andresjjn/soma-arms/docs/media/camera/2026-10-26/lane_marks_measured.jpg

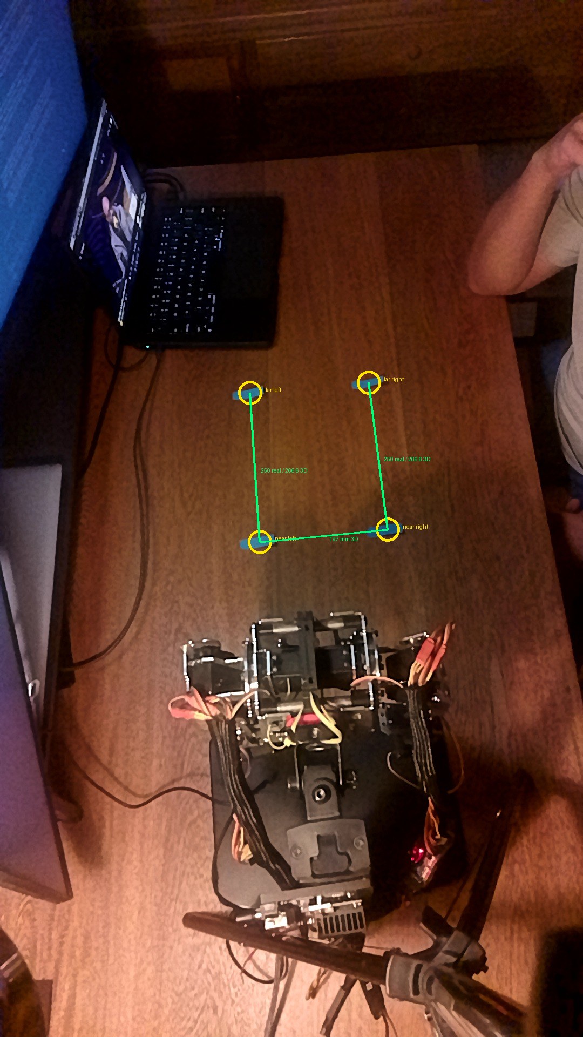
docs/media/camera/2026-10-26/lane_marks_measured.jpg
