andresjjn/soma-arms/calibration/camera_reference.jpg

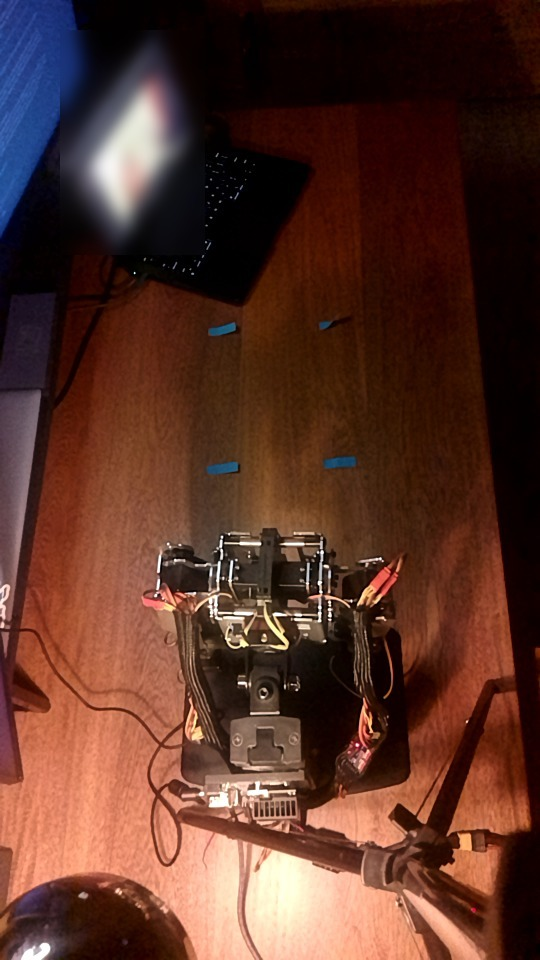
calibration/camera_reference.jpg
