andresjjn/soma-arms/README.md

# SOMA

**S**killed **O**perator via **M**imicry and **A**utonomy.

An embodied AI library for two 6DOF aluminum arms with a powered torso lift.
Real hardware: MG996R servos and an Actuonix L16 linear actuator on two
PCA9685 boards, driven from a Jetson Orin Nano Super running ROS 2 Humble in
Docker.



SOMA is standalone. It describes and drives the arms and the torso, and
nothing else: no chassis, no wheels, no navigation. Putting it on a mobile
base is the integrator's job, done by calling the `soma_torso` xacro macro
with their own parent link.

---

## The robot

| | |
|---|---|
| Arms | 2 x 6DOF aluminum, ThanksBuyer / Red Sun Global frame, "Arm Only" variant |
| Joints per arm | base yaw, shoulder, elbow, wrist pitch, wrist roll, geared gripper |
| Arm servos | 12 x Tower Pro MG996R, 25T spline, 500 to 2500 us over 180 degrees |
| Torso lift | Actuonix L16-140-63-6-R, 140 mm stroke, 20 mm/s, self locking. Off the hanging bench until the printed torso |
| Driver boards | 2 x PCA9685, 16 channels each, one I2C bus: `0x40` right arm and L16, `0x43` left arm, 50 Hz |
| Servo power | ATX bench supply behind a 10 A fuse, one 6 V UBEC per arm |
| Compute | Jetson Orin Nano Super 8 GB, JetPack 7.2, ROS 2 Humble in Docker, on its own wall adapter |
| Camera | Luxonis OAK-D Lite, RGB and stereo depth, verified on the Jetson; from v0.3 fixed on the column looking down at the deck |

Thirteen actuators on one I2C bus. Full part numbers, datasheets, the kit
parts list and every measured value: **[docs/hardware.md](docs/hardware.md)**
and **[docs/wiring.md](docs/wiring.md)**. The first power-up, in July 2026,
ran on a Raspberry Pi 5 and a 2S LiPo; hardware.md keeps that as history.

Honest numbers, because they shape everything else: the frame is advertised
for 25 kg.cm servos and the MG996R delivers about 10, so **useful payload is
around 330 g at 30 cm of reach**. SOMA is built to work in compact poses.

---

## Safety first

SOMA can hurt itself and you. Four things are worth knowing before anything
else, and the full model is in **[docs/safety.md](docs/safety.md)**:

1. **The driver boots on a mock backend and disarmed.** Going live needs both
   a launch parameter and an explicit service call. Two independent gates, on
   purpose.
2. **The lift is limited to 5 to 135 mm of its 140 mm stroke.** Holding a
   command against a stop wedged the lead screw once and it had to be freed by
   hand. It will not happen twice.
3. **Energise the 6 V rails only with both arms at rest in a compact pose**:
   on the hanging bench, hanging with nothing under or around them. These
   servos twitch at power-up.
4. **The real emergency stop is the switch that feeds the servo rails**,
   today the ATX rear switch. Keep it in reach.

---

## Quick start

Nothing below touches hardware.

```bash
# in a ROS 2 Humble workspace
git clone https://github.com/andresjjn/soma-arms.git src/soma-arms
colcon build --symlink-install && source install/setup.bash
```

See the model in RViz with a slider per joint:

```bash
ros2 launch soma_description display.launch.py
```

One arm on its own, which is the model to use with calipers in hand:

```bash
ros2 launch soma_description display.launch.py model:=single_arm.urdf.xacro
```

Run the driver in mock mode and watch the torso rise:

```bash
ros2 launch soma_driver driver.launch.py
ros2 topic pub --once /soma/command sensor_msgs/msg/JointState "{name: [torso_lift_joint], position: [0.135]}"
```

Run the tests, no ROS and no hardware needed:

```bash
python -m pytest soma_driver/test -q
```

---

## Interface

| Kind | Name | Type |
|---|---|---|
| Subscriber | `/soma/command` | `sensor_msgs/JointState`, target positions |
| Publisher | `/joint_states` | `sensor_msgs/JointState`, ramped current pose |
| Service | `/soma/arm` | `std_srvs/SetBool`, arm or disarm the real output |

---

## Roadmap

Every version is a git tag, a video in this README, and a short. The project
has an end: at v1.0 it closes and the arms move on to their next life as the
manipulator of a mobile platform. Anything still missing at v1.0 becomes an
issue, not a reason to keep the project open.

| Version | Milestone | What has to be true | Status |
|---|---|---|---|
| **v0.1** | Calibrated URDF | Every `[calibrate]` length measured with calipers and corrected, servo zeros and ranges captured, model right in RViz, CI green | **TAGGED 2026-08-10.** Caliper session 2026-08-05: real hanging-bench configuration modeled (parallel J1-J4 axes, 33 mm clavicle); FK predicted the fingertips 5.7 mm above the plate and the photos agreed. Axis signs pinned down at the first powered session |
| **v0.2** | Real driver | All 12 joints sign-checked through the ROS driver on both arms; a primitive sequence played end to end under the ramp, filmed (written as `wave`; closed with `hello_left`, see status) | **TAGGED 2026-10-27.** Sign check of all 12 joints on 2026-10-12, the re-seated right elbow and wrist pitch again on 2026-10-26. The wave ran clean on the metal on 2026-10-26 but was not filmed; the film is `hello_left`, which asks more of the driver: real radians from the joint probe, six joints at once, the base at about 142 deg, flowing through its poses, the idle arm limp. [Video](docs/media/video/v0.2_hello_left_2026-10-26.mp4) |
| **v0.3** | Cell geometry and eye-deck calibration | A laser-cut deck with one lane and three pockets per arm, the OAK-D fixed on the column, a pixel-to-deck homography, planar analytic IK. Acceptance: **click a pocket in the image and the gripper touches its center within 5 mm**, 10 of 10, repeated after a power cycle | Reach map and deck drawing done (`scripts/workspace_map.py`, `docs/workspace_map.svg`) |
| **v0.4** | Scripted tending cycle | Pick and place between pockets with no cloud: 30 consecutive cycles per arm without a drop, then a one hour soak with servo temperatures logged | |
| **v0.5** | The supervisor | `soma_agent`: Gemini Robotics ER 2 points, verifies success, reads the part id and recovers a dropped part, through function calls restricted to the primitives (the reasoner proposes, the armed driver disposes; the cloud can never arm the robot). Acceptance: 50 verified cycles with one induced fault recovered | Probe written (`scripts/er2_probe.py`); API billing pending |
| **v1.0** | The operator | Six to seven hours of continuous tending cycles, both arms, a public cycle counter **verified by the supervisor**, the video unedited. Then the project closes | |

Packages arrive with their milestone: `soma_agent` (the ER 2 supervisor) at
v0.5, `soma_operator` at v1.0. There is no MoveIt package and no learning
track on the ladder: the chain is planar, so a short analytic IK replaces a
planner, and the RL work was removed on 2026-10-03 to keep every evening on
the demo. Vision teleop by human mimicry stays in the post-1.0 backlog.

Why a tending cell and not something flashier: each arm is a planar chain
in its own vertical plane, 162 mm from the other one, with no lateral
joint at all. Each arm works a lane, the two arms can never hand anything
to each other, and the honest job for that geometry is machine tending:
pick a part from INPUT, load it into a fixture, unload it to OUTPUT, swap
the roles when INPUT is empty, repeat for hours. The engineering behind
every number is in **[docs/plan.md](docs/plan.md)**.

Videos land here as each tag ships.

- **v0.2**, 2026-10-26: [`hello_left`](docs/media/video/v0.2_hello_left_2026-10-26.mp4), the left arm rises folding the elbow, greets at the top and comes home, flowing, under the ramp (11 s, 720 px).

---

## Layout

```
soma_description/   URDF/xacro, SRDF, RViz config
soma_driver/        PCA9685 driver (mock and real) plus the safety test suite
docs/               see below
scripts/            smoke_test.sh, check_model_driver_sync.py, check_test_results.py
docker/             headless ROS 2 Humble image for building and validating
```

| Document | What it covers |
|---|---|
| **[docs/plan.md](docs/plan.md)** | **the master plan: hardware roles, what the planar arms can reach, the tending cell, the version ladder and the acceptance gate of every version** |
| [docs/log.md](docs/log.md) | the bench and decision log, one entry per session, measured facts first |
| [docs/hardware.md](docs/hardware.md) | every part, its datasheet numbers, and the measured values that override them |
| [docs/wiring.md](docs/wiring.md) | the verified channel map, power chain, connectors, bring-up order |
| [docs/safety.md](docs/safety.md) | the rules, how each is enforced in code, and the incident log |
| [docs/bench.md](docs/bench.md) | validated commands, RViz in a browser, the calibration procedures |
| [docs/session_v02.md](docs/session_v02.md) | the printable runbook of the v0.2 bench session: power-up, the two gates, the sign check, the wave |
| [docs/migration.md](docs/migration.md) | what carried over from the bench driver and what was deliberately changed |

## Development

CI runs on every push: the pure Python test suite, a full ROS 2 Humble build,
`check_urdf` on all three models, a consistency check between the URDF and the
driver, and an end to end run where the mock driver bends the left elbow
and TF confirms the fingertip rising 295 mm.

```bash
bash scripts/smoke_test.sh   # the same thing, locally, inside a ROS environment
```

## License

MIT. See [LICENSE](LICENSE).
