andresjjn/soma-arms/docs/media/camera/2026-10-26/reference_depth.jpg

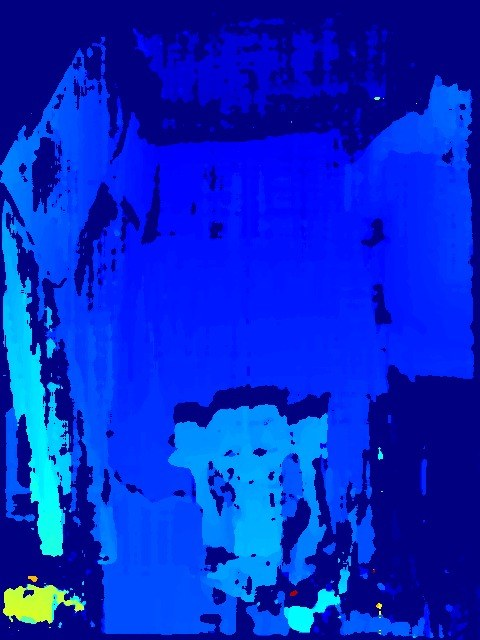
docs/media/camera/2026-10-26/reference_depth.jpg
