andresjjn/soma-arms/docs/calibration_report.md

# Calibration worksheet (v0.1)

Generated by `scripts/calibration_report.py` from
`soma_description/config/dimensions.yaml`. Do not edit by hand;
write the measurements into the yaml (value, status: measured,
date) and into the xacro, then regenerate. CI keeps both in sync.

Angles and axis-to-axis lengths are center of screw to center of
screw. Measure in mm with the caliper; the yaml stores meters.

## arm  (`soma_description/urdf/soma_arm.xacro`)

| dimension | estimate (mm) | status | put the caliper on | measured (mm) |
|---|---|---|---|---|
| `base_lx` | 95.0 | estimated | base box |  |
| `base_ly` | 95.0 | estimated | base box |  |
| `base_lz` | 62.0 | estimated | base box |  |
| `turntable_r` | 42.0 | estimated | turntable disc diameter / 2 |  |
| `turntable_h` | 12.0 | estimated | turntable disc thickness |  |
| `shoulder_off_z` | 45.0 | estimated | disc top face to shoulder servo AXIS (screw center) |  |
| `upper_len` | 120.0 | estimated | shoulder axis to elbow axis |  |
| `fore_len` | 90.0 | estimated | elbow axis to wrist pitch axis |  |
| `wrist_len` | 55.0 | estimated | wrist pitch axis to roll flange face |  |
| `gripper_base_h` | 45.0 | estimated | roll flange face to finger gear axis |  |
| `finger_len` | 75.0 | estimated | finger gear axis to fingertip |  |
| `finger_sep` | 24.0 | estimated | distance between the two finger gear axes |  |
| `plate_w` | 30.0 | estimated | link plate width |  |
| `plate_t` | 60.0 | estimated | outer depth of the plate pair |  |
| `effort_nm` | 1000.0 | estimated | stall torque in N.m (F4 calibration with power) |  |
| `vel_rads` | 3000.0 | estimated | no-load speed in rad/s (F4 calibration with power) |  |

## torso  (`soma_description/urdf/soma_torso.xacro`)

| dimension | estimate (mm) | status | put the caliper on | measured (mm) |
|---|---|---|---|---|
| `bay_lx` | 170.0 | design | electronics bay length (fits the rover deck 194x110) |  |
| `bay_ly` | 110.0 | design | electronics bay width |  |
| `bay_lz` | 70.0 | design | electronics bay height |  |
| `col_h` | 200.0 | design | column height including the 8 mm rails |  |
| `plate_lx` | 180.0 | design | shoulder plate length |  |
| `plate_ly` | 150.0 | design | shoulder plate width |  |
| `plate_lz` | 8.0 | design | shoulder plate thickness |  |
| `arm_x` | 35.0 | design | arm mount offset X on the plate |  |
| `arm_y` | 58.0 | design | arm mount offset Y on the plate |  |

25 of 30 dimensions still need a measurement. v0.1 closes when this number is zero for the `arm` section (`design` entries close with the torso build).
