andresjjn/soma-arms/(commit log)

2026-07-25 Bootstrap SOMA: description and driver packages, safety model, CI
    Standalone embodied AI library for two 6DOF aluminum arms with an
    Actuonix L16 torso lift, driven from a Raspberry Pi 5 over a PCA9685.
    soma_description
    - soma_arm.xacro: the 6DOF arm as a reusable macro, joints named after
    the A to F labels in the kit manual
    - soma_torso.xacro: electronics bay, L16 prismatic lift, torso plate,
    two arms at +/- 45 degrees and the OAK-D head, parameterised by parent
    link so any platform can mount it
    - bench models (single arm, full bench, sim with ros2_control), SRDF,
    MoveIt kinematics and RViz config
    soma_driver
    - servo_map.py: channel map verified with power on, inverted L16
    conven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
    [controllers.yaml, materials.xacro, single_arm.urdf.xacro, soma_arm.xacro, soma_bench.urdf.xacro, soma_bench_sim.urdf.xacro, soma_control.xacro, soma_torso.xacro]
2026-07-25 Fix the smoke test step: container paths and a tolerant TF read
    github.workspace expands to the host path, which does not exist inside
    the job container, so the script was never found. Derive the workspace
    from the working directory instead.
    Also make read_z return empty rather than tripping set -e, and print
    topics plus a /joint_states sample when the transform is missing.
2026-07-26 Align docs and rules with the hardware handoff, fix the I2C root cause
    Corrections against the bench log:
    - The I2C drops were NOT servo inrush current bouncing the ground rail.
    They correlated with handling and vibration, and the cause was a dupont
    jumper broken inside its insulation. The fix was four new short cables;
    the last drop never recovered, even after 20 retries. retry_i2c is now
    documented as a net under isolated glitches, not as the fix.
    - One UBEC is fitted, not two. The second, one per arm, is planned.
    - Added the real supply chain: LiPo 2S, switch and fuse, UBEC 6 V, V+.
    Never the LiPo directly: 8.4 V full against a 7.2 V servo rating.
    Two inviolable rules from the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
    [test_servo_map.py]
2026-07-26 scripts/pi: no-power check and minimum-motion discovery (measured map, L16 on ch3)
    Copied from the canonical Waver repo (ROS2_Docker_twin/scripts/pi/),
    translated to English. Logic identical: 50 Hz + register echo + FULL_OFF
    in the check; 60 ms bursts, one channel at a time, in the discovery.
2026-07-26 dimensions.yaml with provenance, sync test, and the caliper worksheet
    - soma_description/config/dimensions.yaml: single source of truth for
    every physical dimension, with value/status/source/date per entry
    (estimated, measured or design).
    - test_dimensions_sync.py: fails if a xacro literal and the yaml ever
    disagree, if a new literal lands without provenance, or if the torso
    soft limits drift from SERVO_MAP (wedging protection stays pinned).
    - scripts/calibration_report.py generates docs/calibration_report.md:
    the fill-in worksheet for the caliper session. 25 of 30 pending.
    [calibration_report.py, test_dimensions_sync.py]
2026-07-31 servo workbench: browser sliders to jog, zero and range-map each arm servo
    Single file tool for the F4-style calibration session (runs on Pi or
    Jetson). Safety encoded: starts disarmed and FULL_OFF, one active servo
    at a time, 500-2500us clamp, 50us max step per write, ALL OFF button,
    and the L16 torso deliberately excluded (wedging risk, see docs/bench.md).
    Captures zero/min/max per channel into servo_calibration.json.
2026-07-31 workbench: server-side 50 Hz ramp and a drag-safe UI
    The browser now only sets targets; a ramp thread walks the wire at
    400 us/s (same philosophy as rate_limit in the driver), so slider
    gestures cannot snap or stutter a servo. The UI builds its DOM once,
    never overwrites a slider being dragged, and throttles sends to one
    per 120 ms. First pulse on a channel still snaps from the unknown
    physical pose, documented as the one unavoidable jump.
    [servo_workbench.py]
2026-07-31 workbench: include the L16 torso with its own physics
    Channel 3 joins the sliders, but never as a plain servo: band clamped
    to its real 1000-2000 us interface, ramp matched to the actuator's
    20 mm/s so the signal cannot outrun the rod, and auto release 2 s
    after settling. The 2026-07-22 wedge needed a command held for ~8 s
    against a stop; that condition is now unreachable from this tool.
    Per-channel slider ranges come from the server state.
2026-07-31 README: bench milestone, 13 actuators verified live through the workbench
2026-07-31 Roadmap pivot: eye-hand at v0.3, Gemini Robotics-ER 2 orchestration at v0.4
    The ER 2 model (public API since 2026-07-30) becomes the task planner and
    cycle verifier of the operator milestone. New acceptance for v0.3: click a
    point in the image and the arm touches it. Bimanual language-directed pick
    and place at v0.4. Mimicry teleop moves to post-1.0 backlog. New inviolable
    rule: the cloud reasoner proposes, the armed driver disposes; no API
    response may arm, widen limits or bypass the ramp.
2026-07-31 docs/plan.md: the master plan, demo track plus learning track
    Covers hardware roles and the compute topology, what makes a URDF RL ready
    (seven requirements, each tied to an artifact), the model pipeline from
    dimensions.yaml to MJCF, the simulation stack decision (MuJoCo and MJX on
    Apple Silicon; Isaac Lab ruled out because it needs x86 plus RTX), the
    saturated position servo actuator model with the latency and backlash that
    decide sim to real on hobby servos, the RL task ladder L1 to L5, phase by
    phase acceptance criteria for v0.1 to v1.0, sequencing, invariants and
    named risks.
2026-08-02 plan: capture is a task type now, plus one-way door markers
    Section 11 defines when to capture (two stills before the rail comes up,
    one clip at session close), where it goes, and a three minute ceiling.
    Steps that destroy an unrepeatable state are marked FILM BEFORE in
    sections 6 and 10, because a one-way door does not feel different at 11pm.
    Also corrects a stale number: the suite is 50 passing plus 1 skipped, not
    the 24 that migrated from the bench driver. Our own metrics get the
    honest-numbers rule before anyone else's datasheet does.
2026-08-03 driver: minimum-jerk motion profiles, with the ramp demoted to a hard ceiling
    The linear ramp moved every joint at constant velocity with hard corners:
    infinite jerk at start and stop, a load spike into the gearbox both times,
    and motion that looks robotic. trajectory.py replaces it with the classic
    minimum-jerk quintic: velocity follows a bell, duration is chosen so the
    bell PEAKS at the per joint rate limit, and that limit is still enforced
    on every tick as a hard ceiling no polynomial can break. Retargeting
    mid-motion replans from the current position and velocity, so a new
    command never causes a discontinuity, and arming retargets in-flight
    trajectories to the current pose so they decele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
    [arm_controller_node.py, test_trajectory.py, trajectory.py]
2026-08-03 apply_calibration: workbench captures in, reviewed SERVO_MAP proposal out
    Converts servo_calibration.json into asymmetric joint limits around each
    measured zero, ready-to-paste ServoSpec rows and per joint URDF limit
    values. Emits a markdown proposal instead of editing code, because signs
    cannot come from pulse captures alone: every sign ships flagged UNVERIFIED
    until confirmed on hardware. Fingers anchor closed at the captured zero;
    the L16 turns measured stops into a 5 mm soft band, same rule as today
    but measured instead of assumed. Eight tests.
2026-08-04 The measured map: re-splined zeros, asymmetric limits, the hug convention
    On 2026-08-03 every horn was re-splined with its servo holding the
    electrical center, and the mechanical zero plus both travel limits were
    captured per channel with the workbench. This commit makes that capture
    the law of the repo:
    - SERVO_MAP now carries the measured rows. Sign convention (the hug
    rule): negative = inward, as if closing a hug, grasping features
    forward; positive = outward/up. Four arm channels are inverted
    (min_us > max_us) because that is how the mirrored geometry measures:
    rolls and yaws invert on opposite arms, elbows on both.
    - The xacro grows per-joint limit parameters (defaults = right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
    [servo_calibration_2026-08-03.json, soma_arm.xacro, soma_torso.xacro]
2026-08-04 real backend on smbus2, register level, with bus autodetection
    The Adafruit/Blinka stack is a platform detection layer that may or may
    not know JetPack 7.2; smbus2 is a plain kernel ioctl wrapper that the
    bench tools already validated on this exact chip, on the Pi (bus 1) and
    on the Jetson Orin Nano (bus 7). The real backend now speaks the same
    register protocol: 50 Hz via prescale 121, block writes per channel,
    FULL_OFF for release and ALL OFF. The lazy import moves fully behind the
    arming check, so the golden rule fires before any hardware library loads.
    New i2c_bus parameter (-1 = probe /dev/i2c-* for the chip).
2026-08-04 Jetson runtime: the driver in a Humble container with the I2C bus passed through
    JetPack 7.2 carries no ROS 2 Humble, so soma_driver runs in the existing
    validation image with /dev/i2c-7 passed through, host network and IPC for
    DDS, and smbus2 in the image. Boots MOCK and DISARMED like everywhere
    else; the two-gate ritual is documented in the compose header.
2026-08-05 Measured geometry 2026-08-05: hanging bench, planar arms, calibrated URDF
    The caliper session replaced every estimated arm dimension and revealed
    the real bench configuration, which the model now follows:
    - dimensions.yaml: every arm-chain length measured on the right arm,
    new bench section (central box, plate, column anchors), provenance
    per entry. Manual-photo estimates were off by up to 40 mm (upper arm
    79.3 mm real vs 120 estimated).
    - soma_arm.xacro: the arm as built, not as the manual drew it. Both
    arms HANG from their slew discs; J1 to J4 axes are PARALLEL (each arm
    a planar 4R chain plus wrist roll), with a 33 mm clavicle link from
    disc center to shoulder axis. New `side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
    [controllers.yaml, single_arm.urdf.xacro, soma_arm.xacro, soma_bench.urdf.xacro, soma_control.xacro, soma_torso.xacro]
2026-08-11 v0.2 groundwork: motion primitives, primitive CLI, and the sign-check bench tool
    - primitives.py: named poses and sequences as pure, tested data. home is
    the driver's boot pose by construction; compact IS home on the hanging
    bench (documented and pinned by a test); the torso lift is excluded
    from every pose because the L16 is not on this bench. settle_time_s
    exposes the minimum-jerk travel bound so dwells are provably long
    enough.
    - primitives_cli.py (ros2 run soma_driver soma_primitives): publishes
    poses and sequences to /soma/command; `relax` homes, settles, then
    disarms via /soma/arm. Holds zero safety logic of its own: the two
    gates stay in the driver.
    - sign_check_cli.py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
2026-08-11 L1 groundwork: a one-joint pendulum oracle proves the sim pipeline
    Before trusting MuJoCo with the 14-joint bench, trust it with a model
    pencil-and-paper physics can predict. Pattern borrowed from
    kimi-k3-in-c's 13-layer oracle: validate the engine on a miniature with
    the same structure as the real thing.
    - sim/pendulum_oracle.xml: one hinged box carrying the measured forearm
    numbers (75 x 31.9 x 52.8 mm, 160 g estimate), swinging undamped.
    - test_sim_oracle.py: the simulated small-angle period must match the
    analytic pendulum within 1 percent (tonight: 458.82 ms simulated vs
    458.60 ms analytic, 0.048 percent over 7 cycles) and energy must hold
    to 0.5 percent over 4 seconds of RK4.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
2026-08-11 Fix CI: module-level importorskip aborted collection on old pytest
    The ROS container runs pytest 6.2.5 with pluggy 0.13, where a Skipped
    raised while importing one module during collection kills collection of
    every sibling file: the smoke suite collapsed from 125 tests to 0 with
    exit code 5. Diagnosed by instrumenting the smoke step on a throwaway
    branch; the header "collected 0 items / 1 skipped" told the story.
    The oracle module now try-imports mujoco and skips via pytestmark at
    run time, which modern and ancient pytest both handle per-module.
    Verified in both worlds: without mujoco 118 passed 6 skipped, with
    mujoco 123 passed 1 skipped, exit 0 in both.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
    [test_sim_oracle.py]
2026-08-11 INA3221 driver: the power system gets eyes, register level with tests
    Read-only triple-channel monitor over smbus2, same lazy-import pattern
    as the PCA9685 backend. Carries the verified hardware facts of
    2026-08-10: default address 0x44 (0x40/41 belong to the PCA9685 plan),
    stock 0.1 ohm shunts with their honest +/-1.638 A ceiling, and the
    DCB203 battery floor (5S at 3.0 V/cell = 15.0 V) as a queryable
    battery_ok(). Unlike the PCA9685 it carries no arming gates, on
    purpose: no register on this chip can move metal, reading is always
    safe. Mock mirrors the interface for the driver integration that
    follows. Suite: 135 passed plus 1 skipped.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
    [ina3221.py, test_ina3221.py]
2026-08-11 Battery floor raised to 15.2 V to mirror the dock converter's UVLO
    The B0FP1B1F86 12 V dock cuts the pack at 15.2 V by hardware; software
    adopts the strictest guard in the system so the raw-adapter branch
    (which has no UVLO of its own) behaves exactly like the protected one.
    Chemistry floor (5S at 3.0 V/cell = 15.0 V) stays documented beneath it.
2026-08-12 INA3221 default address 0x41: bench-verified map replaces impossible 0x44 plan
    The A0 pin offers only 0x40-0x43 (datasheet SBOS576); the 0x44/45
    options recorded in the hardware inventory belonged to the rover's
    INA219, a different chip. Verified live on Jetson i2c-7 during the
    2026-08-11 soldering session: INA3221 at 0x41 answers manufacturer
    0x5449 ('TI') and die ID 0x3220, PCA9685 #2 at 0x43 (A0+A1 bridged)
    answers a virgin prescale, PCA9685 #1 keeps 0x40 with all 12 servos.
    The address test is edited because the physical fact changed, not to
    make anything pass: the no-collision principle it guards is intact.
    [ina3221.py, test_ina3221.py]
2026-08-12 Multi-board driver: per-channel I2C address routed through a backend fleet
    Every ServoSpec gains an address field defaulting to 0x40, so today
    nothing changes: a test pins that the whole map still lives on board 1
    and must be edited, saying so, on switchover day. The node now boots a
    fleet of mocks (one per board address in the map) and arms a fleet of
    real backends all-or-none: if any board fails to arm, the ones already
    up are disabled and the arming is refused. The golden rule holds board
    by board, before any hardware library loads.
    release() now takes the spec instead of a bare channel: with two boards
    on the bus (bench fact 2026-08-11, 0x40 in service and 0x43 standing
    by) a channel nu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
    [arm_controller_node.py, pca9685_backend.py, servo_map.py, test_multi_board.py, test_node_safety.py, test_servo_map.py]
2026-08-12 Battery veto in the node: INA3221 telemetry plus per-source arming floor
    battery_source parameter, default 'none' (exact pre-monitor behaviour).
    A named profile ('dewalt_5s' 15.2 V mirroring the dock UVLO so software
    fires before the hardware cut, 'lipo_2s' 6.4 V for the bench pack)
    publishes soma/power (sensor_msgs/BatteryState, 1 Hz, INA3221 channel 1)
    and refuses arming below the floor. The floor is a VETO, never a gate:
    nothing here can arm, the two existing gates stay the only way in.
    Fail safe by construction: if a profile is set and no INA3221 answers,
    the node runs and simulates but arming stays refused (the mock monitor
    reads 0 V). An unknown profile refuses to boot outright: broke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
    [arm_controller_node.py, ina3221.py, test_ina3221.py, test_node_safety.py]
2026-08-20 Left arm switchover: channels 9-4 move to board 0x43, numbers unchanged
    The six map rows gain address=0x43, exactly as the fleet design
    promised: six connectors plus one column, zero code. Pulses and limits
    are untouched on purpose, they belong to the servos and their horns,
    not to the driver board. The exact-table test gains the address column
    (a wrong board is now as much of a mis-drive as a wrong channel), the
    two-board pin replaces the nothing-changes pin as its own comment
    demanded, and the boot fleet test expects both boards.
    Board #2 has no silkscreen either: the first armed session re-confirms
    the left arm channel by channel, same ritual as 2026-07-22.
    Suite: 151 passing plus 1 rcl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
    [servo_map.py, test_multi_board.py, test_servo_map.py]
2026-09-01 CLAUDE.md: calibrate explanation level per domain (Andres is an electronics technician with control engineering studies; peer level on electronics/power/control, teaching mode on ROS and architecture)
2026-10-01 Channel map follows the 2026-10-01 harness: right arm 1-6 on 0x40, left 7-12 on 0x43
    Andres rewired both arms on the two-board harness: same order (gripper
    first, base yaw last), new ascending numbers, right being the robot's own
    right. Every pulse, limit and rate is untouched; they belong to the servos
    and their horns, not to the wiring. The dormant L16 moves from 3 to 15
    because the right wrist pitch now owns 3; channel 0 stays empty.
    Tests edited because the physical fact changed: the exact table gets the
    new numbers, test_measured_wiring_2026_07_22 becomes test_harness_2026_10_01,
    duplicate detection now keys on (board, channel), and the calibration
    converter tests use the new channels.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
2026-10-01 wiring.md: point at the renamed harness test
2026-10-01 wiring.md: the 2026-10-01 harness is not yet power-verified, say so
2026-10-01 Servo workbench: both boards, joint list read from SERVO_MAP, sliders start at the calibrated zero
    The workbench kept its own hand-copied channel table (the July layout,
    board 0x40 only), so after the 2026-10-01 rewire it would have mislabeled
    every joint and never reached the left arm on 0x43. It now derives
    board, channel, name and calibrated zero from SERVO_MAP, the single
    source of truth, drives every board on the bus, and finds the bus where
    all of them answer. ALL OFF reaches every board.
    Precision: sliders start at the map zero instead of the 1500 us servo
    center, so the one unavoidable first-pulse snap is as small as a hanging
    arm allows; a go ZERO button, +/-5 us nudges, and the an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
    [servo_workbench.py, test_workbench.py]
2026-10-02 Workbench: ALL OFF cuts each board on its own; start with the boards present
    Found on the bench: unplugging one arm's board made the workbench's
    request handlers raise on that board, and ALL OFF walked the boards in
    one loop, so a missing board could stop the cut from reaching the rest.
    A kill switch must not depend on every board being healthy: each board
    is now cut on its own and a failure is only reported. The workbench also
    refused to start with a board missing; it now runs with the boards that
    answer and leaves the missing board's joints off the page, with a warning.
    [servo_workbench.py]
2026-10-02 Workbench --raw: every channel of every board for a loose spare servo
    Bench need on 2026-10-01: proving each output of each board with one
    known-good spare servo, channel by channel. Raw mode lists all 16
    channels of every board that answers, starts each slider at the 1500 us
    neutral, and refuses calibration captures so a test can never pollute
    the calibration file.
    [servo_workbench.py]
2026-10-02 Channel map back to the proven descending layout (15-10 on 0x40, 9-4 on 0x43)
    The morning's 1-12 map came from a header counted from the wrong end:
    neither PCA9685 board carries a channel silkscreen. With it, the right
    arm went dead (pulses went to empty outputs 1-6) and the left arm's
    pulses landed on neighbouring joints, which is why a closed gripper
    command opened it. A pulse sweep plus a spare servo moved output by
    output (servo_workbench.py --raw) proved the physical truth: the
    August layout, gripper first, descending. L16 back on 3.
    Kept from the detour: duplicate detection keyed on (board, channel),
    the harness contract test (now test_harness_proven_2026_10_01), and
    apply_calibration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
    [check_model_driver_sync.py, servo_map.py, test_apply_calibration.py, test_servo_map.py]
2026-10-02 Workbench: watchdog disarms on a board reset; ARM re-configures the boards
    Seen on the bench 2026-10-01: reconnecting a board made both PCA9685s
    lose their shared 3.3 V logic supply for an instant. They came back at
    power-on defaults (MODE1 0x11, oscillator asleep; prescale 0x1E, 200 Hz)
    and every output went dead, while the page still showed ARMED and live
    pulses. A tool that reports ARMED over sleeping boards is lying.
    A watchdog now reads MODE1 and the prescale of every board once a
    second; a reset or a silent board disarms everything and puts the fault
    on the page. ARM re-runs the board init, so recovering is one click
    after fixing the supply.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
    [servo_workbench.py]
2026-10-02 Workbench: master slider for every joint at once, arms in two columns
    Bench request 2026-10-01 after capturing every servo's zero/min/max:
    see what happens when all joints get a signal together. One master
    slider: left walks each joint toward its own captured MIN, right toward
    its own MAX, center is zero, so 50 % is half of each joint's own travel.
    Direction follows the capture labels, which keeps inverted joints right.
    An amplitude cap (25 % by default) and per-arm checkboxes come with it:
    twelve servos at full travel at once will collide, both yaws can swing
    about 180 deg inward. Same 400 us/s ramp; a joint without a pulse yet
    snaps to its zero first, never straight to a far target.
    The p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
    [servo_workbench.py, test_workbench.py]
2026-10-02 Driver: disarm when a PCA9685 resets while ARMED
    Seen on the bench 2026-10-01: both boards (0x40 and 0x43 on i2c-7) lost
    their shared 3.3 V logic supply for an instant and came back at power-on
    defaults, MODE1 0x11 (oscillator asleep) and prescale 0x1E (200 Hz
    instead of 121 for 50.0 Hz). Every output went dead. The workbench got a
    watchdog for it; the ROS driver had the same blind spot: it would keep
    writing LED registers to a sleeping chip and keep reporting ARMED.
    Backend: every board now answers config_fault() / is_configured().
    RealPca9685 reads MODE1 and PRESCALE and flags the SLEEP bit or a
    prescale other than 121; the mock is always healthy unless a test calls
    simulate_reset(). The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
    [arm_controller_node.py, pca9685_backend.py, test_board_reset.py, test_node_safety.py]
2026-10-02 Calibration of 2026-10-01: every arm joint re-captured on the two-board bench
    Andres re-captured, with the servo workbench, the mechanical zero and
    both travel limits of all 12 arm servos. The raw file is committed next
    to the August one (calibration/servo_calibration_2026-10-01.json). The
    rows were generated from it, not typed: each MIN capture lies on the
    negative (hug) side and each MAX on the positive side, and every joint's
    direction was checked against the August measured inversion before
    writing (all 12 agree; the generator refuses on any mismatch).
    Why now: the August numbers had drifted by up to 205 us (18 deg on the
    right elbow), and several August limits sat BEYOND today's measur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
    [servo_calibration_2026-10-01.json, soma_arm.xacro, soma_bench.urdf.xacro]
2026-10-02 Workbench sequence player: primitives.py sequences, minimum jerk, step by step
    The workbench can now play any SEQUENCE from soma_driver/primitives.py,
    the same source the ROS driver's soma_primitives CLI uses, so a motion is
    defined once for both paths. plan_sequence converts each pose through
    SERVO_MAP (clamped) and gives every step the driver's worst-case
    minimum-jerk travel time at the 2.5 rad/s cap; the player interpolates
    all joints of a step on one synchronized minimum-jerk profile at 50 Hz
    (the 400 us/s slider ramp would be far too slow for a wave). Step-by-step
    mode waits for a click after each step, to check every direction on the
    metal before running a sequence at speed. Stop, ALL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
    [servo_workbench.py, test_primitives.py, test_workbench.py]
2026-10-03 Right-arm wave: raised with the base, three forearm waves, hand opening on each out-swing
    Five wave_* poses and SEQUENCES['wave'] for the v0.2 video. The arm goes
    up with yaw (the one direction verified on the metal, negative = forward)
    and never with the shoulder, whose forward travel may be 25 deg; the
    elbow curls the forearm about 25 deg off vertical and oscillates between
    -1.57 and -2.09 rad while the gripper opens and closes. Every arm value
    keeps at least 0.3 rad to a measured limit, every step moves at most
    1 rad (the finger, inclusive), every dwell leaves 0.25 s over the
    minimum-jerk travel. The left arm stays at home. The elbow direction is
    not verified yet, which the docstring says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
    [primitives.py, test_wave.py]
2026-10-03 soma_primitives --step: one pose per ENTER, q unwinds home along the proven path
    The sequence player moves into player.py, pure and tested without ROS;
    primitives_cli.py becomes a thin rclpy adapter. In step mode the human
    confirms every pose but the last. An abort does not jump to home (from
    the top of the wave that is a 2 rad elbow move through territory whose
    sign may be wrong): it retraces the states already published, newest
    first, each at most 1 rad per joint with settle plus margin, and ends
    at home. The player never calls /soma/arm; relax stays the only caller,
    and only with False.
    parse_cli drops the whole --ros-args segment (the old filter only
    removed the token itself). Exit code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
    [player.py, primitives_cli.py, test_player.py, test_primitives_cli.py]
2026-10-03 Workspace map: planar reach of each lane and the deck drawing for the laser cutter
    scripts/workspace_map.py does planar FK and analytic IK of the 4R chain
    (yaw, shoulder, elbow, wrist pitch plus the 150 mm tool) from the
    measured dimensions and the measured limits, and reports the x interval
    of each lane where a vertical gripper can reach a given height. Signs
    are hypotheses except the yaw: --flip mirrors one joint and its limits
    so the map is redone the evening the sign check lands.
    Findings of 2026-10-03 (URDF signs, 0.1 rad inside every limit): the
    lanes sit at y = +-62.3 mm, 124.6 mm apart; reach is short and not
    monotonic in deck height (a 140 mm band at plate level, about 240 mm at
    60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
    [test_workspace_map.py, workspace_map.py]
2026-10-03 ER 2 probe: one pointing call to gemini-robotics-er-2-preview, key from the environment only
    scripts/er2_probe.py sends one frame and a list of labels, prints the
    raw answer, the parsed [y, x] points (0 to 1000) and their pixels, the
    latency and the token usage: the numbers the v0.5 cost and latency log
    needs before anything is designed around the model. The model id is
    configuration (SOMA_ER2_MODEL or --model) because ER 1.5 and 1.6 were
    retired within months. The Google SDK is imported only inside query(),
    so the module and its parsers are tested where no SDK and no network
    exist, and a missing key stops main() before any call. No ROS, nothing
    that can reach the driver.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
    [er2_probe.py, test_er2_probe.py]
2026-10-03 Plan restructured: task-gated ladder to a two-station tending cell, learning track removed
    docs/plan.md rewritten around what the arms can physically do: each arm
    is a planar chain in its own vertical plane, 124.6 mm from the other,
    so each works a lane and the honest job is machine tending (INPUT,
    MACHINE with a lamp, OUTPUT; roles swap when INPUT empties; both arms
    interleaved; the supervisor verifies every cycle). Versions are gates,
    never dates: v0.2 driver (sign check plus the wave), v0.3 cell geometry
    and eye-deck calibration (laser-cut deck, camera on the column,
    homography, planar IK; click a pocket and touch its center within 5 mm),
    v0.4 scripted cycle with a one hour soak and tempe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
    [soma_arm.xacro, soma_torso.xacro]
2026-10-04 The bench and decision log moves into the repository: docs/log.md
    SOMA is an independent project and its log lived in the Waver repository
    by inertia of the July handoff. From 2026-10-03 the log is docs/log.md
    here, with the 2026-09-01, 2026-10-01 and 2026-10-03 sessions carried
    over in English (resumption and the inrush incident, the network and
    camera verification, the harness lesson, the shoulder limit cycle, the
    verified yaw direction, the plan restructure and the Gemini facts). The
    safety incident log gains the three incidents it was missing (inrush,
    harness counted from the wrong end, board reset after a 3.3 V glitch).
    CLAUDE.md and the README point at the log; the Waver files become a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
2026-10-04 Handoff for the next (local) session: v0.2 bench runbook and a corrected sign check
    The cloud session closes on 2026-10-04 and work continues on Andres's
    Mac, which can reach the Jetson. docs/next_session.md carries the audit
    of the bench tools (soma_sign_check walks both arms, drives the right yaw
    within 1.4 deg of its stop, leaves a joint displaced on Ctrl-C and
    prescribes an axis flip where a SERVO_MAP mirror is the right fix; no
    Jetson recipes; no way to relaunch with allow_real; a wrong claim that
    arming never moves anything; the XT60 is not an emergency stop) and the
    approved plan to fix them before the first armed session.
    Clau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
2026-10-09 Sign check rewritten: pure logic in sign_check.py, a thin rclpy adapter, tests
    The audit of 2026-10-04 found the old soma_sign_check unfit for the
    bench: it walked all 12 joints with no per-arm option, sent the right
    yaw to +0.25 rad (1.4 deg from its measured +0.2749 stop), left a joint
    at its target on Ctrl-C, and answered a mismatch with an axis flip in
    soma_arm.xacro, which is the wrong fix: metal moving opposite to the
    hug convention is a driver fix (mirror the SERVO_MAP row), and every
    planar <axis> line uses ${side}, so a flip there changes both arms.
    sign_check.py (no ROS, the player.py pattern):
    - joints per arm in confidence order (yaw first, it is verified on the
    metal and prov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
    [player.py, sign_check.py, sign_check_cli.py, test_player.py, test_sign_check.py, test_sign_check_cli.py]
2026-10-09 soma_primitives --step: discard keys typed during a step
    Same hazard the sign check closes with fresh_input(): an ENTER pressed
    while a pose is still moving waits in the terminal buffer and answers
    the next prompt the moment it appears, so a double ENTER walks two
    steps of the wave with nobody looking at the first. Step mode now
    flushes pending input before every prompt.
    The docstring also says what Ctrl-C does today: it ends the program
    and leaves the arm at the last pose, still held by the armed driver.
    q is the abort that unwinds along the proven path.
2026-10-09 Jetson operating docs: gate 1 by relaunch, what arming really sends, the ATX stop
    docker-compose.jetson.yml launches with allow_real:=${ALLOW_REAL:-false},
    so gate 1 finally has a recipe on the Jetson: ALLOW_REAL=true ... up -d
    --force-recreate, closed again by a plain relaunch. The header names
    two traps: restart: unless-stopped keeps a container's configuration
    across reboots (one created with ALLOW_REAL=true comes back with gate 1
    open), and compose reads .env on its own (ALLOW_REAL never goes there).
    `docker compose config` validates both forms.
    docs/bench.md, new section 6: ssh, i2cdetect on bus 7, compose up /
    logs / down, how new code reaches the driver, a `soma` helper that
    passes a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
    [soma_arm.xacro]
2026-10-09 docs/session_v02.md: the printable runbook of the v0.2 bench session
    Checkboxes and a pen, steps 0 to 9 as planned: prerequisites, aborts
    and the capture before the ATX; power-up; an optional mock rehearsal;
    gate 1 by relaunch; gate 2 by Andres, out loud; the right-arm sign
    check; the decision (any reversed ends motion for the day, the fixes
    are desk work); the wave in step mode, then filmed; the shoulder
    threshold with its pulse table; close, the log entry, and the left arm
    the same day if everything was clean.
    What it adds to the plan:
    - The expectation tables are generated by expectation_table() and a
    test keeps the printed copies identical to what the tool commands.
    - RViz is not part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
    [test_sign_check.py]
2026-10-09 Log of 2026-10-09; the handoff is done and goes
    docs/log.md gets the desk session that executed docs/next_session.md:
    what was built, the corrections found on the way (rclpy's SIGINT
    handler shuts the context down on Humble; arming sends the believed
    pose at the servo's own speed; no --flip after a driver fix; the model
    check needs no metal; gate 1 outlives a reboot; an ATX stop leaves the
    driver armed; typeahead; the soma helper's quoting), and a desk
    prediction for the model check, from a pure Python FK of the xacro:
    planar joints drawn negative = forward on both arms, the wrist rolls
    drawn CW (right) and CCW (left) seen from above for a negative command,
    and both grippers drawn closing, t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
2026-10-12 Workbench: the watchdog reads the bus under the lock
    Every access to the workbench's shared SMBus held the fleet lock except
    the 1 Hz watchdog's reads of MODE1 and PRESCALE. One SMBus serves both
    boards, and smbus2 sets the slave address and then transfers in two
    separate syscalls: a watchdog read landing between the two calls of a
    50 Hz ramp write would send that write to the other board. (The kernel
    serializes each transfer, so this never showed up as an OSError; the
    risk is a misaddressed write. With today's map such a write lands on an
    unused channel of the other board, by luck, not by design.)
    The pass is now check_boards(), entirely under the lock; _watchdog only
    loops over it. Two te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
2026-10-12 Jetson driver container: scripts/jetson_driver.sh, since there is no compose
    Found on 2026-10-12: the Jetson has no `docker compose`, so every
    compose recipe in bench.md, safety.md, wiring.md and the runbook could
    not run there. The container had been made by hand with `docker run`
    and allow_real:=true on 2026-10-02, and restart: unless-stopped kept
    gate 1 open across reboots for ten days. The docs also had the wrong
    repository path and a DHCP address that has since changed.
    scripts/jetson_driver.sh closed|open is docker-compose.jetson.yml as
    one `docker run`, same flags. It refuses while the driver's last
    arming event in its log is ARMED (removing an armed driver kills it
    before it cuts th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
2026-10-12 Log of 2026-10-12: the right arm's signs verified on the metal
    The first joints moved through the ROS driver: the right-arm sign check
    gave 6 of 6 ok, report in calibration/. Also logged: Andres's
    impression that the MG996R are weak and loose, what tells backlash,
    torque and V+ sag apart, and his decision to keep building and to
    evaluate servos with real position feedback when these become the
    limit; the OAK mounted looking at the operator instead of the plate,
    too close and upside down, with a yaw check that was confirmed but not
    run; the Jetson as found; and the plan changes from the review against
    the ER 2 docs, for a later edit of docs/plan.md.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
2026-10-12 Model fixed against the metal: wrist roll and finger axes, pinned by an FK test
    The sign check passed 12 of 12 on the metal on 2026-10-12, so the driver
    was right everywhere. The model was not: seen from above, a negative
    wrist roll turns the gripper inward on the metal (counterclockwise on
    the right arm, clockwise on the left, as Andres saw it), and the URDF
    drew both the other way. The URDF also drew a positive finger command
    as the two fingers closing and crossing, while the metal opens.
    soma_arm.xacro: the wrist roll axis goes from ${side} to ${-side} and
    both finger axes from 0 1 0 to 0 -1 0. Both arms disagreed the same
    way, so the shared lines are the right place. The driver, the joi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
2026-10-13 colcon test runs the driver suite, and CI fails when no test ran (squash)
    Squash of claude/compassionate-proskuriakova-b5edda (5 commits, CI green
    on its last two runs, 37977558879 and 37977774034). Its intermediate log
    entry made a claim that its last commit corrects; the squash keeps only
    the corrected version.
    - soma_driver/setup.py declares extras_require={'test': ['pytest']}.
    colcon picks pytest only from setup.py; without it, it fell back to
    unittest, found no test, wrote no XML and passed: "Summary: 0 tests"
    on main (runs 37964849489, 37965586501 and every run since).
    - scripts/check_test_results.py fails unless at least one test reached a
    verdict (tests minus skipped minus e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
2026-10-13 soma_primitives: Ctrl-C walks the arm home, over covered ground only
    From the work of the "Ctrl-C unwind like q" session (2026-10-09, left
    uncommitted in its worktree), reviewed and integrated on 2026-10-12.
    The bug it found, re-checked on main before merging: the unwind
    retraced the walked path literally, so `q` after the descending
    wave_probe, one move from home, climbed back through all three swings:
    12 moves. On the merged code it is 1 move (and 3 from the top of the
    climb, as before).
    - unwind() starts from the FIRST time the arm held its current pose and
    goes back one forward move at a time: only moves already made, each at
    most 1 rad, never the same pose twice. A move cut short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
2026-10-13 hardware.md and README describe the Jetson bench; July kept as history
    From the work of the "Update hardware.md and README for the Jetson
    bench" session (2026-10-09, left uncommitted in its worktree), reviewed
    and integrated on 2026-10-12.
    - README: two PCA9685 boards and the Jetson instead of one board and a
    Raspberry Pi, a "Servo power" row, the camera's real role. Safety
    point 3 no longer says "folded": on the hanging bench the first armed
    tick sends every joint to its hanging zero without a ramp, so arms
    folded by hand would jump. It says hanging at rest, as wiring.md does.
    - hardware.md: the bill of materials of today (ATX, two UBECs, the
    Jetson, the INA3221 off the bus), the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
2026-10-13 Inviolable rules 1 and 4 follow the Jetson bench; same-day reports keep the time
    Changed with Andres's explicit approval (2026-10-12):
    - Rule 1: "including over SSH on the Pi" becomes "on the Jetson", the
    computer that drives the boards since 2026-07-30.
    - Rule 4: "both arms folded, resting on the bench" becomes "both arms
    hanging at rest, nothing under or around them". On the hanging bench
    the hang is the compact pose, and folding the arms by hand before
    arming is the dangerous thing: the first armed tick sends every joint
    to its hanging zero with no ramp (TestWhatArmingSends).
    The right arm's sign check ran twice on 2026-10-12 (23:40, and 23:55 in
    the left arm's armed window, wh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
2026-10-13 Camera on the Jetson desktop, and ER 2 marks what it finds on the frame
    scripts/oak_view.py: a live view of the OAK-D Lite for aiming the camera
    and filming, RGB turned 180 deg (the camera is mounted upside down) and,
    with --depth, disparity beside it (extended disparity: the work area can
    sit near the stereo pair's minimum range). `s` saves the full-resolution
    frame to /tmp/soma_cam/frame.jpg for the probe; --snapshot saves one
    settled frame without a window. Tested on the Jetson with --snapshot
    --depth: 1920x1080 RGB right side up and 640x480 depth, USB SUPER. It only
    reads the camera.
    scripts/er2_probe.py: with no labels it asks with the pointing prompt of
    Google's robotics overview, ver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
2026-10-13 Handoff for the next session, and the evening of 2026-10-12 in the log
    docs/next_session.md: the state at the end of the day (main and the
    Jetson on fe67031, gate 1 open and the driver disarmed, the camera that
    must move, the depthai 3 examples and their local edits) and the pending
    list in order: the first ER 2 call, the gesture gripper (proposed, not
    decided), the arm mimic (post-1.0, not decided), the catalog fix for
    grippers_open before demo runs, the bench items toward the v0.2 tag, the
    plan edit, and the cleanup that waits for a yes.
    docs/log.md: the branches merged after review, the reworded rules, the
    camera viewer, what the depthai 3 examples taught (4 SHAVEs on the Lite,
    orientati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
2026-10-13 One gripper follows one hand: tracker on the OAK, bridge to the driver
    A bench experiment decided by Andres on 2026-10-12, one joint. The OAK-D
    Lite runs the MediaPipe palm detector and hand landmarker (8 fps on
    RVC2); how open the hand is sets how open one gripper is, in proportion.
    The tracker runs on the Jetson host (depthai 3 venv) and prints targets;
    a bridge inside the driver's container publishes them to /soma/command
    for that arm's driven finger only. It cannot arm, a lost hand sends
    nothing, and the driver clamps and ramps every target.
    The first runs on the bench shaped it: a wrist-position lock so the
    other hand cannot take over, a palm size that survives tilt, misreads
    skipped,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
2026-10-13 hand_gripper: the closed end holds, and the target moves smoother
    On the metal the left gripper followed Andres's hand well but fluttered
    near closed: 57 of 216 targets in 107 s sat between 0 and 0.2. The
    follower now takes the median of 3 readings (no one-frame spike reaches
    the gripper), averages with weight 0.3 instead of 0.5, and holds the
    ends with hysteresis: at or below 0.2 it shuts and stays shut until the
    hand passes 0.3; the open end mirrors it at 0.85 and 0.75. Replayed on
    the same run: 131 targets, none between 0 and 0.2.
    Two filter tests rewritten on purpose: they pinned the old filter (no
    median, no held ends), which Andres asked to change; no hardware fact
    moved. --smoothing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
2026-10-13 hand_gripper --present: open then close the hand, the arm lifts and shows
    For Andres's video. The bridge's new Presenter follows the hand with the
    gripper; after the hand stays open 0.5 s and then closes, it holds the
    gripper shut, curls the elbow to -1.65, lifts the base to -0.52 and rolls
    the wrist +-0.25 rad on a 3 s sine until the input ends, then walks home
    in reverse (wrist, base, elbow). Every target is streamed at 10 Hz on a
    minimum-jerk ramp, at most 2 rad/s, 0.3 rad or more from every measured
    stop.
    Why this pose: by the URDF's estimated masses a level forearm 50 deg
    forward asks the base for about 9.9 kg.cm, the MG996R's measured limit;
    this one asks about 7, the designed wave's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
2026-10-13 hand_gripper --present lifts the straight arm with the base only
    The first run on the metal curled the left elbow toward -1.65 with the
    arm hanging, and the forearm folded in and jammed against the central
    box from the start of the curl, where the model has 45 mm to spare: at
    large angles the elbow does not go where the model believes. Incident
    row in docs/safety.md.
    The show now swings the straight arm forward with the base alone
    (--lift, 0.52 rad = 30 deg by default, at most 0.7) and rolls the wrist
    +-0.25 rad; the elbow, shoulder and wrist pitch are never commanded, and
    a test pins that. By the model, 5.7 kg.cm on the base at 30 deg, 45 mm
    from the body.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
2026-10-13 hand_gripper: a lost hand walks home and releases; lift up to 45 deg
    Once a hand seen before has been gone for --release-after seconds
    (default 2), the tracker sends `release`. The bridge walks the arm home
    if it was raised, waits 1 s for the driver's ramp to land, and disarms:
    every servo goes limp, never while the arm is up (it would fall). The
    script can now disarm but still never arm: one SetBool request, built
    with data False. The test that forbade naming SetBool at all is
    rewritten on purpose to pin exactly that.
    --lift now goes up to 0.79 rad (45 deg): about 8.0 kg.cm on the base by
    the model, 80% of the MG996R's measured torque, so above 0.7 rad the
    show lasts at most 15 s.
    Co-Auth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
2026-10-13 hand_show.sh: one take of the hand show, armed only on a typed word
    A lost hand now disarms, so each take has to arm again; Andres asked for
    it in one command. hand_gripper.py still cannot arm. The new launcher,
    run on the Jetson in a terminal, checks that every arm joint of both
    arms reads 0.0 on /joint_states (hand_gripper.py --home-check, read
    only: the first armed tick sends the believed pose with no ramp),
    prints the rule 4 checklist, and calls /soma/arm only if "arm" is typed
    at its prompt; then it starts the tracker and the bridge with the given
    bridge options. An armed driver is not asked again. Gate 1 is not
    touched.
    Tested on a fake docker and a fake tracker; a mutated copy that a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
2026-10-13 hand_gripper: the show does its wrist rolls even if the hand leaves
    At 45 deg on the metal the wrist barely rolled: the hand left the frame
    right after the trigger and the release walked the arm home before the
    show had begun. The show is now a fixed number of full wrist cycles
    (--rolls, 4 of 3 s by default, within the existing time caps), then it
    comes home on its own. A release asked during the raise or the show is
    deferred until the show ends, then home, then the cut; before the
    trigger it is still immediate.
    The tracker keeps running after sending release, with a heartbeat line
    the bridge ignores: the write is how it learns the bridge has ended,
    and it keeps the pipe open so a Ctrl-C st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
2026-10-13 Camera on its mast: frames turned 90 deg, and a coverage check
    The OAK-D Lite is now fixed on a mast above the central box, tilted over
    the arms' forward arc and rolled a quarter turn. oak_view turns frames
    90 deg counterclockwise; the hand tracker does it with an ImageManip,
    since the depthai 3 camera node only offers 180 deg (both checked on
    real frames; addRotateDeg turns the opposite way, so -90 there).
    camera_check is a new catalog sequence: one straight arm at a time,
    swung forward by the base only to 15, 30 and 40 deg and back down the
    same way (40 deg is about 7.3 kg.cm by the model, the designed wave's
    load; the elbow stays out after the jam of 2026-10-12).
    scripts/camera_coverage.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
2026-10-20 camera_coverage: a color difference beside the depth one; handoff
    Metal inside the stereo blind zone has no depth, so the depth difference
    cannot see an arm right under the lens. Each capture now also reports
    the largest blob whose gray level moved against the baseline image,
    saved with the baseline. Checked on the Jetson: clean on an unchanged
    scene. The handoff is rewritten for where 2026-10-13 left off.
2026-10-26 soma_joint_probe: the real angle per radian, read with a phone level
    Every joint's radians are still the nominal 2000 us = 180 deg; the sign
    check proved directions, not magnitudes, and the left elbow jammed
    against the central box where the model saw room. The probe moves one
    planar joint at a time with the rest at 0.0, so the inclination of the
    link it drives, read from the vertical, is the joint's angle. It reads
    0.0 first, walks a staircase forward (0.2 rad by default, a ceiling per
    joint, 0.1 rad inside every captured stop), asks for a reading per
    stair, and walks back down the same stairs on q, x, Ctrl-C, end of input
    or any error. A least squares line gives the real scale, the zero er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
2026-10-26 Camera on a tripod, measured on four lane marks; reference images
    The OAK-D Lite now sits on a tripod behind and above the robot. Four
    blue marks on the desk (under each closed gripper tip and 250 mm forward
    of each) were located in the image and turned into 3D points with the
    camera's factory intrinsics and the aligned depth: both 250 mm runs read
    266.6 mm (depth +6.6% at 1.1 to 1.25 m, so the homography positions and
    depth only confirms), about 0.9 mm per pixel along a lane at full
    resolution. The two near marks are about 186 to 199 mm apart against
    124.6 mm between the model's arm planes: to measure with a ruler.
    The reference view for re-aiming the tripod, the annotated marks and
    the de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
2026-10-26 Log: gripper tips measured 180 mm apart, the model says 124.6 mm
    Measured with a ruler with both arms armed and swung forward to 30 deg
    by the base. The likely cause is in dimensions.yaml itself: the model
    puts each arm's plane on the disc face, not on the mid-plane of the
    52.8 mm arm sandwich mounted outboard of it (177.4 mm between arms with
    that correction). To confirm with calipers before the URDF, the reach
    map and the gripper clearance analysis change.
2026-10-26 camera_align: camera and robot against a reference, in percent
    A live view on the Jetson with the reference as a ghost, the center
    line and the robot's box. The camera reading fits a similarity to ORB
    features of the scene; the robot reading is its reference crop found in
    the live frame, minus the camera's own shift. Camera only: no driver,
    no gate. 27 tests, 611 passing.
2026-10-26 camera_align: --save with a countdown, so nobody is in the reference
    The first reference had a person beside the robot: their features sit
    in the scene the camera reading fits, and they move.
2026-10-26 Camera reference of 2026-10-26 evening, and the wrist pitch repair
2026-10-26 Zeros re-captured after the right elbow repair
    The right elbow's horn was mounted reversed and loose. Re-seated, its
    zero first landed three teeth off (1425 us) and the wave no longer fitted
    its forward travel; seated again and fine-tuned to 935 us, its October
    zero, with the backward end measured at 560 us. Three more zeros were
    re-captured with the arms hanging: right yaw 750, left yaw 2450, left
    shoulder 1055. The tests that pin these numbers are updated because the
    hardware changed, not to make a change pass.
2026-10-26 Sign check after the elbow re-seat: right elbow and wrist pitch ok
2026-10-26 Joint probe: elbow scales measured, 0.78 right and 0.93 left
2026-10-27 Joint probe on every planar joint: scales, gear play, a board hypothesis
2026-10-27 pwm_clock_check: a board's real PWM frequency, read on a Jetson GPIO
    The joint probe found every right arm joint (board 0x40) at about 0.83
    of its command and the left arm (0x43) near 0.95: a pattern that
    follows the board. A fast PCA9685 oscillator shortens every pulse by
    one factor. With no meter on the bench, the Jetson's gpiomon timestamps
    the edges of a free channel jumpered to header pin 29. Servo channels
    stay FULL_OFF; it refuses while the driver container runs.
2026-10-27 SERVO_MAP in real radians: the joint probe's scales, and the wave redrawn
    Every planar joint keeps its measured pulses and zero; its radian limits
    are the nominal ones times the scale the probe measured (right arm 0.81
    to 0.87, left 0.87 to 1.05). The tests that pin the rows are updated
    because the hardware fact is now measured. The wave's in-swing no longer
    fitted the right elbow (-2.09 against a real reach of -1.94): redrawn
    with the same base angle and swing, moved down to -1.35 .. -1.84.
2026-10-27 Smoke test: the left elbow clamps at -1.8850 real rad, tool rises 295 mm
2026-10-27 elbow_reach: find where the right forearm touches, after the wave did
    The redrawn wave's wave_raise_2 (elbow -1.60 real, base -0.87) folded
    the right forearm into the robot on its first step-mode run. The map's
    elbow end is the servo's, not the metal's. elbow_reach takes the wave's
    posture and curls the elbow in 0.1 rad stairs that stop at -1.5, for
    the gap to be measured before every step.
2026-10-27 hello: a flowing right-arm greeting inside the measured limits
    The arm rises folding the elbow, rolls the wrist in and out five times
    at the top while the gripper opens and closes, and comes down
    unfolding. Dwells are the travel times plus 0.1 s, so it never stops to
    wait. The base ends 0.1 rad inside its real reach and short of vertical;
    the elbow folds before the base passes the horizontal, keeping the base
    under the load the wave has already held.
2026-10-27 hello: higher, a more open elbow, the palm waving on the wrist pitch
2026-10-27 hello: the elbow waves the forearm at the top, the arm nearly straight
2026-10-27 limp_arm: the idle arm hangs with its signal cut, only from home
    At the hanging zero gravity torque crosses zero and a held arm hunts in
    its gear play. A new driver parameter, limp_arm, cuts the signal of one
    arm while the other works. It is refused unless every joint of that arm
    is at home, now and in its target, because a released arm servo
    anywhere else falls (CLAUDE.md rule 3); commands for a limp arm are
    dropped. RELEASE_WHEN_SETTLED is untouched; the two gates are untouched.
2026-10-27 hello_left: four poses set by hand in the workbench, played as a greeting
    Andres posed the left arm (its base reaches about 142 deg real, the
    right about 119) and read the pulses of each pose. They are kept as
    pulses, the record of what was set on the metal, and converted through
    the calibrated map. The rise and the fall fold the elbow while the base
    passes the horizontal.
2026-10-27 Flowing sequences: blend through poses instead of stopping on each
    A rest-to-rest minimum-jerk segment ends at zero speed, which reads as a
    pause on every pose. The driver replans from the current position and
    velocity, so a sequence declared in BLENDED sends each pose at a fraction
    of its travel and flows through it; home is still reached and held.
    hello_left blends at 0.7: 7.0 s instead of 10.8. The dwell contract is
    relaxed only for declared sequences, and a tick-by-tick simulation of
    the driver's planner proves the corner cutting stays inside the soft band
    and within 0.1 rad of the poses' span.
2026-10-27 Dimensions re-measured with a caliper; the IK works in the measured lane
    The arm chain moved by about 1 mm a link. The tool is now one direct
    reading (150.0 closed, about 100 open), and the IK uses it rather than
    the sum of its parts. The lane is the measured 81 mm, half the 162
    between the closed tips: the model gains a plane offset along the
    parallel axes (a DH d) so its chain works there too. mount_h is left as
    it was until a disc-to-tip reading settles a 42 mm disagreement.
2026-10-27 v0.2: the real driver, filmed with hello_left
    The criterion named the wave; the wave ran clean but was not filmed, and
    the film is hello_left, which asks more of the driver. The README says
    so in the roadmap row. Video at 720 px, reviewed: no people, the monitor
    unreadable at that size.
2026-10-27 arm_side_view: the arm's real joint angles from the side, down from the IMU
    The hanging right arm measures about 45 mm shorter than its chain: it is
    bent somewhere. A side view reads each link's tilt directly, free of
    scale and depth error. The OAK-D Lite on this bench has a BMI270: its
    accelerometer, rotated into the color camera by the factory extrinsics,
    gives down in the picture however the camera is mounted, and its pitch
    warns when perspective would bend the reading. Camera only, no driver.
2026-10-27 arm_side_view: a region of interest, and the camera pitch even without markers
2026-10-27 arm_side_view: the IMU-to-camera axes as measured, not the factory matrix
    Upright and level, the accelerometer read +9.69 on IMU y: camera y is
    -IMU y. Looking down from the tripod it read mostly IMU z: camera z is
    -IMU z. The factory extrinsics, read as a swap of x and y, put down
    sideways on an upright frame.
2026-10-27 arm_side_view: a numbered reference image of every candidate, --pick, mm from depth
    The tape check of 2026-10-27 validated the depth scale (box top to tip:
    332 mm by camera, 370 - 38 = 332 mm by tape). Reflections on the metal
    got picked as markers, so the script now draws every blue candidate
    numbered on latest_side.jpg and lets the operator pick the axes.
2026-10-27 The clavicle rises: a DH theta offset closes the 45 mm gap
    The hanging right arm measured 295 mm disc to tip against 338.7 in the
    model. From the side, the OAK showed the shoulder axis 15.6 mm above the
    disc axis, behind it, and the rest of the arm hanging straight with the
    caliper lengths. The clavicle leaves the disc at 118.5 deg from straight
    down; the shoulder's zero takes it back out. clavicle_angle goes into
    dimensions.yaml, the xacro and the IK; mount_h is re-measured at 327.2.
    The FK now predicts the hanging tip 36.8 mm over the plate against 38
    measured, pinned by a test.
2026-10-27 xacro: the clavicle offset moves the shoulder origin only, not its frame
    Turning the shoulder frame back by the clavicle angle twisted the whole
    arm in the URDF (test_model_directions caught the tip moving backward on
    a forward command). The frame keeps the turntable's orientation; only
    the origin moves.
2026-10-27 Log: the clavicle rise by tape, no CAD for the kit, the physics of the reach test
2026-11-09 firmware/eyes: SOMA's eyes on an ESP32-S3 Dual-Eye, drawn as math
    Two round GC9A01A panels on one SPI bus, drawn in stripes through two
    DMA buffers. Each pixel comes from a pure eye model (gaze, pupil, blink,
    mood as lid shapes); commands arrive as lines over USB serial. The pure
    parts build for the host and are tested with the suite. Off the ladder
    and off the safety path, noted in docs/plan.md. Espressif's GC9A01 driver
    is vendored under its Apache-2.0 header.
2026-11-09 firmware/eyes: the design is data, previewed on the Mac with the board's own model
    style.json holds every visual number (sizes, colors, the lid shape of
    each mood, timings) and generates the header the firmware compiles; a
    test keeps the two equal. tools/preview.py builds the same eye_model.h
    for the host and draws a contact sheet. On the board, set KEY VALUE
    changes the design live, style prints it back as JSON, save keeps it in
    NVS. The first preview caught the sad and angry lids swapped: fixed in
    the JSON, not in code.
2026-11-09 firmware/eyes: a fast path checked against the reference eye, about 50 fps
    The reference model per pixel ran at about 5 to 8 fps on the board. The
    fast renderer builds color tables only when the design changes, computes
    the lids per column and needs no square root per pixel; a still eye is
    not redrawn and a gaze-only change redraws just the box around the iris.
    Host tests hold it to the reference (864 states, 0 px beyond tolerance)
    and the window to the full frame. Measured on the board with the new
    stats command: about 50 fps while the gaze moves, 34 fps full frames.
2026-11-09 firmware/eyes: tools/eyes.py talks to the board, one command per argument
2026-11-10 firmware/eyes: img and live, to preview other designs as stills on the panels
    img E receives one eye's picture in RGB565, in 4 KB blocks the board
    acknowledges (Arduino's USB-Serial/JTAG driver drops bytes when its
    receive buffer fills: 45 of 115 KB arrived at first). design_tour.py cuts
    the eyes out of contact sheets drawn at panel size and shows them after
    the current design. Used to put the two Claude Design proposals on the
    real panels without implementing them.
2026-11-10 firmware/eyes: the lids become shutter blades, the eye unchanged otherwise
    The lids keep their curved, mood-carrying shape and are drawn as a
    camera shutter: gunmetal blades, a machined bright edge along the lid
    line, and joints radiating from the center. Three new style fields and
    two colors; zero edge and zero joints give the plain lid back. The fast
    renderer matches the reference model on 864 states.
2026-11-11 Fix five defects from the independent review since v0.2
    - eyes: gaze_box clips both ends and may be empty, draw_eye skips an
    empty box (a gaze_reach that carried the iris off the panel hung the
    board in an endless loop, and with save it hung every boot)
    - eyes: valid() bounds the radii to the panel, timings to >= 0 and seams
    to 8; set refuses an invalid design and the board drops one from NVS
    (iris_r above 120 read past the root table)
    - eyes: the redraw box covers the glint on its own; draw_eye and img
    share one stripe-buffer index
    - driver: limp_arm given at launch is applied through the same check,
    not only reported; an invalid launch value is reset
    - arm_side_view: five marke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
2026-11-11 Bring stale 2026-08-05 numbers up to the 2026-10-27 measurements
    col_h 0.370 (tape, mount_h + mount_lz/2 agrees), single-arm model at
    0.3272, the 32.7 mm rising clavicle, the 81 mm lane in docs/plan.md, a
    superseded note in docs/hardware.md, the test count in CLAUDE.md, and
    the review logged in docs/log.md.
2026-11-11 firmware/eyes: the voice's phase 0, microphone and speaker over USB
    docs/voice_plan.md: SOMA listens through the eye board and answers in
    Spanish through Gemini Live, with the conversation on a host relay (the
    Mac now, the Jetson later) so voice and orchestration share one brain.
    Phase 0, passed: Espressif's ES7210 and ES8311 drivers (Apache-2.0, as
    Waveshare adapted them to Wire) at 16 kHz; rec, play, vol and selftest
    on the line protocol, parsed and tested on the host; stats reports
    whether audio started and the last reset reason. tools/audio_check.py
    measures dBFS per channel: voice peaks -13 to -22 dBFS over a -63 dBFS
    floor, and the speaker reads +56 dB at the board's own microphone.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
2026-11-11 firmware/eyes: the voice's phase 1, a Gemini Live conversation over USB
    The board streams its microphone and plays a queue in two tasks on core 0
    while the eyes keep drawing on core 1 (eyes/frames.h: framed both ways,
    acked speaker window, a 16 s ring in PSRAM, a 3 s timeout that closes the
    microphone if the host goes quiet). tools/voice_relay.py holds the Live
    session: key from the Keychain, 24 to 16 kHz resampling, half duplex while
    SOMA speaks, latency and tokens logged per turn, no tools at all.
    End to end: two spoken turns in Spanish, 1.6 and 2.0 s from the last word
    to Gemini's first audio. Fixed on the way: a frame buffer shared across
    cores, clicks counted as speech, stale frames af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
2026-11-11 firmware/eyes: SOMA sleeps with its eyes shut and wakes on "despierta"
    The firmware boots with the eyes closed and closes them when a stream
    ends (sleep and wake, eased lids). The relay starts asleep, with a
    transcription-only Live model hearing only speech (VoiceGate), wakes on
    "despierta" with a short greeting, and sleeps again on "duérmete", Ctrl-C
    or a lost session.
    The eye director follows how people look in a conversation: the pupil
    dilates while thinking and stays still while speaking, phrases start
    looking away and end looking back, fewer blinks while hearing.
2026-11-11 firmware/eyes: "despierta" wakes SOMA in 0.7 s, not seconds later
    The sleep gate cut the audio after the phrase, so the transcription model
    waited for silence that never came. The relay now sends audio_stream_end
    when the gate closes and also wakes on the partial transcription.
    Measured with a synthesized "SOMA, despierta": no wake within 6 s before,
    0.6 to 0.7 s after.
